WilliamMBaker/split_keyboard_1/README.md

# split_keyboard_1

Split keyboard project akin to [this](https://www.graz.io/articles/bayleaf-wireless-keyboard) one, and [this](https://github.com/merrittlj/aurora40) one.

## Requirements

- Split, preferably reversible PCBs or at least both sides be manufactured together and snapped/cut appart.
- Large battery, months long battery life.
- Wireless, bluetooth connection to target device.
- Plug and play, HID complient(?).
- Low profile, switches and keycaps.
- Ortholinear and no saggering.

## ErgoGen

[Link](https://ergogen.cache.works/).

## ZMK

[Link](https://zmk.dev/)

## Layout
[Link](https://www.keyboard-layout-editor.com/)

## Resources

- [Nice!Nano v2](https://mechboards.co.uk/products/nice-nano-v2)
- [Choc switches](https://typeractive.xyz/products/choc-switches)
- [Hot swap sockets](https://typeractive.xyz/products/hotswap-sockets?variant=45742200324327)
- [Switches](https://typeractive.xyz/products/mbk-keycaps)
- [Power switches](https://typeractive.xyz/products/power-switch)
- [Diods](https://typeractive.xyz/products/smd-diodes)
