WilliamMBaker/split_keyboard_1/split_keyboard_1/3d_models/nice_nano_v2.step

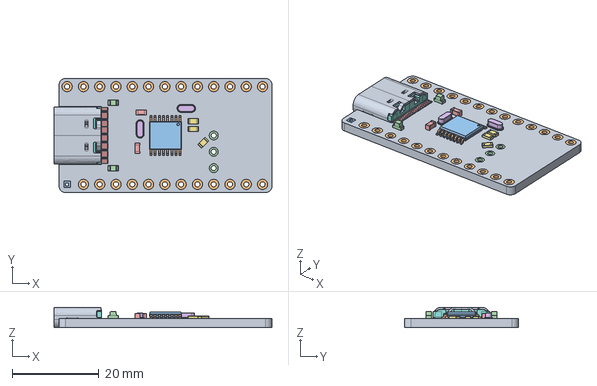
[picture p1: CAD file, 2025-09-16]
split_keyboard_1/3d_models/nice_nano_v2.step
50.3 x 26.3 x 4.68 mm
