WilliamMBaker/split_keyboard_1/split_keyboard_1/3d_models/mill-max 12pin 310-13-112-41-001000 v1.step

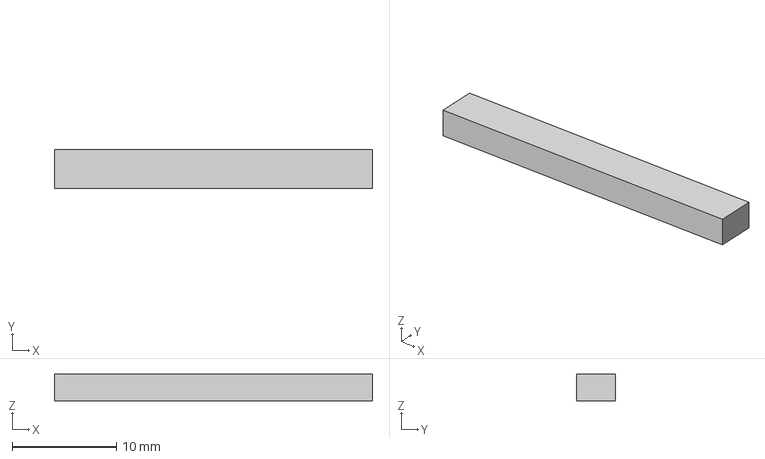
[picture p2: CAD file, 2025-09-16]
split_keyboard_1/3d_models/mill-max 12pin 310-13-112-41-001000 v1.step
30.5 x 3.71 x 2.54 mm
