WilliamMBaker/split_keyboard_1/(commit log)

2025-09-03 Create nice!nanoV2 schematic and start on footprint
    [split_keyboard_1.kicad_pcb, split_keyboard_1.kicad_sch]
2025-09-04 Add switches, fill out nice!nanoV2 symbol
    [split_keyboard_1.kicad_pcb, split_keyboard_1.kicad_sch]
2025-09-05 on/off switch symbol and start on footprint
    [split_keyboard_1.kicad_pcb, split_keyboard_1.kicad_sch]
2025-09-06 Add reset and power switch
    [split_keyboard_1.kicad_pcb, split_keyboard_1.kicad_sch]
2025-09-06 Add centre screw hole
    [split_keyboard_1.kicad_pcb]
2025-09-07 Add 3D models to power and reset switches
    [split_keyboard_1.kicad_pcb]
2025-09-07 move switches to edge
    [split_keyboard_1.kicad_pcb]
2025-09-07 add ground plane
    [split_keyboard_1.kicad_pcb]
2025-09-16 Add 3d models
    [mill-max 12pin 310-13-112-41-001000 v1.step, nice_nano_v2.step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]
